hEr0bR1ne/surgeryBoxProject-next/docs/comparison-and-next.md

# 两版比较与 Next 迭代记录

比较日期：2026-09-09。本文以实际 Git 提交和源码为依据，未进行实物训练验证。

## 来源与结论

- 原工程：<https://github.com/hEr0bR1ne/surgeryBoxProject>，本地基线 `0187e78`（2.1.1）。
- 衍生工程：<https://github.com/ZiliShao222/surgeryBoxProject>，本次基线 `5d58073`。
- GitHub API 将衍生工程标为 `fork: false`，但其 Git 历史包含原工程的 `0187e78`。因此代码确实继承自原工程，只是没有 GitHub fork 元数据。
- 从原基线到衍生版主分支共有 14 个提交（包括合并提交）；差异为 89 个文件、12,591 行增加、558 行删除。归档硬件工程和文档也计入统计，不能把全部新增行数视为新功能。
- Next 以衍生版当前主分支为基础继续开发。保留作者和提交历史，原仓库不覆盖。

原工程已经具备软硬件训练闭环；衍生版将其拓展成包含教师端、体位与视觉感知、AI 分析和学习记忆的训练平台。下一阶段最值得投入的是模块边界、协议可靠性和可复现验证，而非继续向大型页面文件叠加功能。

## 功能与结构比较

| 维度 | 原工程 2.1.1 | 衍生版 5d58073 | 判断 |
| --- | --- | --- | --- |
| 硬件基础 | ESP8266 D1、双相编码器、舵机刹车、电机 | 继承硬件平台，增加诊断命令和 IMU 桥接 | 可继承，但硬件标定需重新核对 |
| 通信 | WiFi 热点、HTTP echo、UDP 训练事件 | 增加 USB 串口收发，UDP 保留 | 适合有线训练站；两种传输尚未完全统一 |
| 编码器 | A 相中断判向 | A/B 相边沿计数、正交状态转换、原始计数与引脚诊断 | 可观察性更好；沿用原每 tick 距离不等于已经重新标定 |
| 电机 | 回卷操作实现较简单 | 非阻塞回卷、15 秒上限、回零判断和方向切换 | 主循环响应能力改善；超时和反向策略需实测 |
| 体位 | 无独立 IMU 体位门控 | IMU 欧拉角，侧卧保持 3 秒，离开体位暂停和恢复 | 有价值的训练前置条件；阈值受安装姿态影响 |
| 界面 | 登录、训练、题库、记录、AI 对话 | 师生独立界面、注册、账户主题、中英文切换 | 明确区分教学管理与学员训练 |
| 摄像头 | 摄像头与手势识别基础能力 | 扩展相机控制、手部追踪和训练关联 | 保留成果，后续重点验证切换和释放资源 |
| AI | Nursing Mentor 对话 | 学员复盘、教师建议、LangGraph 流程、持久训练记忆 | 从问答转向训练数据分析；效果仍需样本评估 |
| 文档 | 无根 README | README 与 docs 专题文档、历史硬件测试目录 | 交接改善明显，但部分文档落后于代码 |

对应源码：`src/encoder.cpp`、`src/motor.cpp`、`src/imu_bridge.cpp`、`src/wifi_udp_server.cpp`、`simulator/app/hardware/serial_connector.py`、`simulator/app/imu_posture_reader.py`、`simulator/app/ui/teacher_shell.py`、`simulator/app/ai_training_graph.py`、`simulator/app/agent_memory.py`。

## 已确认的问题和待验证事项

1. **串口测试误报成功（本次修复）**：原 `SerialConnectionTestThread` 即使完全没有收到协议回复也发出 `True`；任意 ACK 或遥测也可能被视为成功。Next 要求本次探测收到精确 `ACK: HELLO_PC`，超时报告失败。
2. **配置与生成文件被提交（本次修复当前版本）**：本地与示例 AI 配置含硬编码密钥，且有 19 个被跟踪的 `.pyc`。Next 示例改为环境变量；本地配置、用户设置和缓存退出版本跟踪。旧提交仍存在，密钥持有人应撤销旧密钥；本迭代不重写上游历史。
3. **IMU 桥接未启用（接线复核更正）**：`main.cpp` 已注释 `imuBridgeInit()` 和主循环桥接调用，默认 ESP8266 控制走 COM6，桌面 IMU 读者走独立 COM3。`imu_bridge.cpp` 仍保留原始二进制透传实现，部分等待/回卷函数也残留调用；若将来重新启用桥接，会与同一 Serial 上的日志、文本协议混用。当前不能把该风险描述为默认运行状态。若合并为单串口，应实现统一读取与明确分帧。
4. **固件等待仍是阻塞循环（待解决）**：`waitForCmd`、`waitForCmdAny`、`waitShortPull` 在等待期间轮询部分服务，没有完整超时状态机。`Stop` 在普通处理分支未直接清除 `sequenceRunning`；不同等待分支对运行时命令的退出语义不同。应先建立命令状态表，再用台架验证暂停、终止、回卷与重新开始。
5. **编码器尺度需复核（待验证）**：计数方式变为 A/B 双相边沿后，`distancePerTick` 仍为 `0.0000507`。应拉出已知长度并比较 ticks，确认比例和方向；目前不能断言训练距离准确。
6. **主页面职责过多（待重构）**：`main_window.py` 约 183 KB，两个拔管训练实现分别约 135 KB 和 125 KB，AI 图约 77 KB。UI、训练状态、设备生命周期和数据分析交织，改一项容易影响另一项。
7. **运行环境与文档不一致（部分纠正）**：README 仍称缺少 openai，但当前 requirements 已包含；MediaPipe 模型与下载脚本在文档出现，当前树没有对应文件。图形界面、模型资源和真实设备仍需独立验收。
8. **存储依赖启动目录（待修复）**：`storage.app_root_dir()` 使用 `Path.cwd()`，从不同目录运行会得到不同的数据根；不能只修图片路径就认为整个应用支持任意目录启动。

## Next 0.1.0 的范围

- 继承衍生版所有功能和 Git 历史。
- 串口连接测试发送 `HELLO_PC` 前清空旧输入，使用单调时钟限制等待，只接受精确响应；异常交给线程现有错误处理。
- 示例 AI 配置从 `DASHSCOPE_API_KEY`、`DASHSCOPE_BASE_URL`、`DASHSCOPE_MODEL` 读取；默认模型与 DashScope 地址保持兼容。
- 停止跟踪本地配置、用户设置及 19 个 Python 字节码文件，忽略后续产生的训练数据。上游已经跟踪的历史训练数据未批量删除。
- 标记桌面版本 `Next 0.1.0`，增加无需 GUI、模型或硬件的协议测试与 CI。
- 本次不改变电机输出、体位判定阈值、训练事件距离或临床教学内容。

## 后续顺序

| 优先级 | 工作 | 验收条件 |
| --- | --- | --- |
| P0 | 单串口接入和明确消息分帧 | IMU 高频输入、设备日志与指令交错时不丢帧、不抢占端口 |
| P0 | 固件命令状态机 | 任意训练阶段 Stop、拔线、超时均进入明确定义状态，重新开始可重复 |
| P0 | 编码器与回卷台架验证 | 已知长度标定、反向、回零、堵转、超时及急停逐项有记录 |
| P1 | 提取训练状态与设备服务 | 虚拟训练、UDP、串口共享状态模型；纯逻辑可自动化测试 |
| P1 | 固定数据目录与账户数据迁移 | 从不同启动目录运行读取相同记录，迁移保留原记录 |
| P1 | 依赖与模型资产说明 | 新 Windows 机器按文档即可启动且缺模型时有明确提示 |
| P2 | AI 报告评估和记忆策略 | 固定样本复盘可解释，重复训练不会重复累计记忆，失败有明确回退 |

## 验证

自动检查与实物验证分开记录。执行 `python -m unittest discover -s tests -v` 和 `python tools/check_python_sources.py`。固件执行 `pio run -e d1`。没有连接实物时，不将编译通过视为电机、体位或完整训练验收通过。

### 本次实际结果（2026-09-09）

- Python 3.11.7：7 项回归测试全部通过，涵盖串口静默、无关 ACK、日志/二进制噪声、精确握手、断线异常，以及无本地配置时的 AI 默认配置与环境变量优先级。
- 43 个 Git 跟踪的 Python 源文件语法解析通过；未发现扫描规则覆盖的内嵌 provider key 形式。该检查不代表完整历史密钥审计。
- PlatformIO `d1` 固件编译成功（Espressif8266 4.2.1 / Arduino framework 3.1.2）；RAM 32,032 / 81,920 字节，Flash 319,543 / 1,044,464 字节。
- 未上传固件，未启动完整 GUI，未调用真实 AI 服务，未进行电机/IMU/相机实物验证。
