hEr0bR1ne/surgeryBoxProject-next/releases/surgerybox-v3-3.1.6/README.md

# 3.1.6 固件与验证记录

- `firmware.bin` 为 2026-11-13 烧录并校验的 WEMOS D1 R1 镜像。
- `upload.log` 摘录烧录校验结果，`operator-test.log` 摘录同一固件的带载回卷全过程关键报文。
- `validation.json` 记录镜像 SHA256、测试结果和回卷结果。

[交接说明](../../docs/AI-HANDOFF.md) · [实机验证](../../docs/v3-hardware-validation.md)
