hEr0bR1ne/surgeryBoxProject-next/releases/surgerybox-v3-3.1.0/README.md

# 3.1.0 / protocol=8：已烧录，用户现场测试通过

上电自动零点；无需手动标定两端；无拉出上限、无提前停车死区。舵机75°/秒，较3.0.1提高50%。
方向2计数增加，返回上电零点即关断，然后50ms停机、方向1释放1秒。显示归零与重连不改变上电零点。
跟踪失效后不能自动重设零点，须重启；保留编码器/失联/错向/堵转/120秒连续运行保护。

当前COM4已烧录3.1.0，290464字节Hash校验通过；boot=15e2c4-dd5d290c。25次只读检查通过，home有效、编码器errors0、输出关闭。烧录前隔离驱动VM/VCC及舵机正极，因为D8/GPIO0在复位期间可能误动。
软件到零关断不能保证机械惯性零超调，仍须现场观察停车结果。
构建、策略静态检查、13项GUI测试和13项SDK测试通过；本轮进行了只读串口验证，结束SAFE并释放COM4，没有发送启动执行器的指令。
主接口见docs/v3-hardware-api.md。旧protocol=7 SDK不能用于新版，旧ZIP不应再交接给上位机开发者。

后续用户测试证据见operator-test.log：多次舵机与灯开关、回卷token1715103486完成；首次舵机启用仍有一次error5，完成位置pos86/home0。以docs/AI-HANDOFF.md为当前交接入口。
