hEr0bR1ne/surgeryBoxProject-next/docs/archive/AI-HANDOFF-before-v3-release-20261109.md

# 历史工作记录（不作为当前指令）

# 当前交接：V3统一MCU接口（2026-11-09）

**最新用户要求覆盖下方旧端点/行程限制：当前COM4已烧录3.1.0 / protocol=8，290464字节Hash校验通过，boot=15e2c4-dd5d290c。25次只读检查通过，home有效、encoder errors0、deadzone_ticks0、extension_limit0、各路输出关闭。上电首个有效编码器样本自动记home=0；不需人工两端标定，无拉出上限、无最小行程、无提前停车死区，到零即关方向2再释放1秒。方向2的编码器符号已由日志验证为+1；舵机75°/秒，较3.0.1加快50%。保留编码器失效/失联/错向/堵转/120秒运行上限。显示ZERO与重连不改home，跟踪失效后本次home失效且不自动重设。最新接口见docs/v3-hardware-api.md。用户已重新确认执行器隔离并授权烧录；本轮未发送启动执行器的指令。退出发送SAFE并释放COM4。用户报告缓动后刹车不再断连，日志多次动作成功，但首次重新启用仍出现一次error5，不宣称根因已完全消除。以下3.0.0/3.0.1记录和历史标定要求不得覆盖本段与最新用户指令。**

**最新：用户确认执行器隔离并授权烧录后，COM4已写入3.0.1，296128字节Hash通过，boot=15e2c4-d57f700a。25次只读检查通过，编码器errors0、所有输出关闭、端点清空。未发送动作；1°/20ms缓动和1%停止余量待带电动作验证，错误5仍未确认修复。证据在releases/surgerybox-v3-3.0.1-candidate/。下方未烧录/板载3.0.0等描述均是先前阶段；旧交接ZIP未更新。**

**源码候选3.0.1，板载3.0.0：舵机1°/20ms非阻塞缓动，最后一步后500ms才启动回卷；停止余量10%→1%（最少32计数），近目标启动容差128→8。仅离线验证，未烧录/开串口/发送动作；旧交接ZIP仍3.0.0。错误5仍未解决，用户当前保留接线现场。**

**后续故障：用户舵机指令后需反复重连；日志确认Windows COM4读写error 5，重连boot不变。根因未定，不能直接认定电源或MCU复位。用户选择“暂不改线，先保留现场”，没有再发动作/烧录。先读v3-hardware-validation.md最上方，勿宣称实际动作后的通信稳定性通过，也不自动重连重放动作。**

新增全功能测试端tools/StartHardwareTest.cmd，配套tools/v3_test_client.py，说明docs/v3-test-console.md。
12项GUI检查及实机只读连接通过，电脑端不需要重烧MCU。当前已打开测试窗口并连接COM4（PID21840），串口由窗口占用；其他工具需先断开/关闭窗口。
独立测试端交付包releases/surgerybox-v3-test-console-20261109.zip已核验SHA256。连接只查询状态，未启动执行器。

用户要求硬件接口全部做好交给上位机开发者，已完成。当前板载firmware/v3（3.0.0 / API v1 / protocol=7），上位机入口host_sdk/surgerybox_v3.py。
先看[v3-hardware-api.md](v3-hardware-api.md)及[v3-hardware-validation.md](v3-hardware-validation.md)。不使用旧主程序、旧串口连接类或单项GUI。
可直接转交releases/surgerybox-v3-hardware-api-20261109.zip，包内23文件及SHA256已核验；镜像与当前COM4一致。
已通过构建/写入校验、12项SDK测试、四路隔离实机接口验收、100次状态查询及旧会话/重放/看门狗检查。
最终电机/灯低、舵机无脉冲、I2C有效，端点未登记；COM4已释放，用户确认电机及舵机正极仍隔离。
完整带负载回卷及1秒机械释放、停车惯性尚需上位机联合测试。下方为历史信息，不代表当前固件状态。

---

> **2026-11-09 最新100%版：用户明确要求最大驱动，确认VM仍主板5V、电机此前直连5V能转；收到当前执行器供电隔离确认后，COM4已烧录MOTOR_I2C_PROBE protocol=4、PWM1023/1023，286048字节写入Hash通过。长按与原行程/心跳/无进展/时限保护保留，18项GUI回归通过；串口确认CAPS pwm1023、缺端点HOLD拒绝、旧KEEP不启动，输出低、编码器errors=0，串口释放。先断电重登两端后用户手动测试，本轮未发有效驱动。实际驱动型号仍未核实，100%不是升压补偿。启动器tools/StartMotorProbe.cmd已更新；勿用旧25%/组合工具。详见[v3-bringup.md](v3-bringup.md)。**

> **2026-11-03 第三代接线变更：用户报告已更换MT6701，VDD接3.3V、M接GND；灯信号D3。现在仅USB供主板，驱动板、舵机、灯取主板5V，外部24V已不使用。插USB时电机短暂动作，原因及板载固件未确认；当前重新枚举到CH340 COM4。先读 [v3-bringup.md](v3-bringup.md)，不要把下面第二代供电、标定和烧录记录当作第三代已验证事实。**

> **2026-09-15 新板更换：原板据用户反馈损坏，已为新WEMOS D1 R1烧录同一电机禁用联调固件。COM4，ESP8266EX，MAC 80:7d:3a:11:d5:8b，写入校验通过。串口确认motor_enabled=0、active=0、home=0、D7/D8低，Winding被拒绝；BRAKE:ANGLE:0、LIGHT:OFF、ENC?查询正常。24V断开时核对，未验证外设实际动作；COM4已释放。**

> **最新实物状态：2026-09-11T01:08:29（本机北京时间），电机禁用的上位机联调主程序已烧录COM4，写入校验通过。实测19条电机命令全部返回ERROR: motor_disabled_handoff；motor_enabled=0、matrix=0、active=0、D7/D8均低。舵机指令0°、LIGHT:OFF及ENC?查询正常。24V断开期间核对，未测试外设实际动作。COM4已释放。**

> **2026-11-03 最新烧录：当前COM4为ServoTuner舵机独立调试固件，非主程序。全4MB原Flash已备份到hardware_backups/before_servo_tuner_20261103_v3/，新固件写入校验通过。握手TUNER:1、状态STATE:0,90,90，控制输出关闭，未发送角度指令。调试GUI已打开且未连接；COM4已释放。后续保持电机供电隔离，舵机首次启用默认从90°指令开始，需先核实机构允许。详见v3-bringup.md。**

> **2026-11-03 第三代刹车标定已整合源码：释放180°、弱阻尼120°、锁紧50°，微调50~180°，单次最多5°。本机主程序编译通过，尚未烧录；板上仍为上述ServoTuner。详见docs/brake-calibration.md及docs/v3-bringup.md。以下旧0°/55°/125°是第二代历史值。**

> **2026-11-03 编码器联调最新状态：当前COM4为ENCODER_I2C_14BIT。用户改接D4/GPIO4→M+Z，VDD=3.3V，D5=SDA、D6=SCL；固件D4输出HIGH。0x06读取与跨圈测试通过，运动采样1030帧均有效，约一圈约1.6万计数，I2C errors=0。停流回执重试恢复，复核通过、COM4已释放。未写EEPROM。主程序仍用A/B且尚不兼容新接线，新距离/原点/行程未标定；执行器保持隔离。详见v3-bringup.md。**

> **2026-11-05 最新需求：用户仅要相对位置，不要求毫米换算或尺量标定，200mm试验未完成且未生成系数。已在隔离执行器条件下打开“SurgeryBox · 编码器相对位置”GUI（PID 3448），COM4被实时读取占用。诊断ZERO后相对计数0，14位读取正常、errors=0；一圈16384计数，窗口显示相对角度/圈数。未烧录新固件、未设机械原点。先看v3-bringup.md最新开头。**

> **2026-11-05 电机最新：当前COM4为MOTOR_I2C_PROBE，端点0~18949、控制1894~17055；中段8034。用户恢复原5V驱动供电后，执行一次IN1 PWM/IN2 LOW官方接法短脉冲，无位移、no_progress停止，随后MS核验输出低、未解锁、串口释放。尚未确认实际驱动芯片；A4950官方VM要求8~40V。用户要求只按官方指引，不做旧组合试验；暂停进一步点动，先核实型号/供电。刷机前隔离电机电源，RAM参考复位失效。详见v3-bringup.md最新开头。**

> **2026-11-09 用户最新反馈：100%版本测试成功，方向2回卷；方向1使机构允许拉出，否则摩擦轮锁住。待确认方向1需短按还是持续按，不自动加入释放脉冲；仍protocol=4，未改固件或发送动作。见v3-bringup.md最新段。**

> **补充确认：方向1只需短按即可保持可拉出，无需持续驱动。后续正常回卷完成应停机→方向1短暂释放→停止；释放毫秒值未标定，尚未实现或烧录。故障/急停不自动触发反向释放。见v3-bringup.md。**

> **2026-11-09 当前protocol=5：用户指定方向1运行1秒，已隔离确认后烧录COM4（287792字节Hash通过）。正常回卷松手/收回端正常完成：停50ms→方向1/100%1000ms→停止；故障急停不反向。释放允许无位移，保留心跳/编码器/位移与物理范围限制。23项GUI回归与编译检查通过，实机CAPS确认1000ms、缺行程拒绝释放，输出低、编码器errors=0；串口释放，未执行有效驱动。用户须重登两端后验证机械释放。前述protocol=4已被替代，详见v3-bringup.md。**

> **2026-11-09 当前protocol=6：已隔离确认后烧录288000字节，新增LIGHT:ON/OFF/?；D3/GPIO5回读LOW→HIGH，用户却观察灯未亮。当前D3留HIGH供测量，COM4释放，电机/舵机仍隔离、无有效驱动；等待模块VCC-GND及IN-GND电压。GUI连接会关灯，暂不启动连接；灯尚未通过，整机接口阶段未开始。详见v3-bringup.md。**

> **2026-11-09 灯最终结果：线路修正后，用户确认D3高电平实体灯“亮了”；已发LIGHT:OFF并查询确认D3=0，COM4释放，当前protocol=6。此前未亮/待测量/留HIGH为历史。可进入MCU/上位机接口整合，但主程序仍电机禁用且未整合新I2C，1秒自动释放完整机械效果及停车惯性仍需联调验证。详见v3-bringup.md。**

# SurgeryBox 硬件与上位机交接（AI 首读）

更新日期：2026-09-09。本文件是本次交接的状态摘要。较早文档中的引脚、角度、测试计划和“尚未烧录”记录可能已经过时，以本文件的状态和对应源码为准；不能把已写代码等同于实机验证通过。

## 给接手者 / AI 的任务

用户已完成下面列出的硬件单项测试，上位机联调由接手者负责。请先阅读本文件、根目录 `AGENTS.md` 和对应代码，不要求用户重新口述所有历史。先在无电机输出条件下检查上位机流程；电机异常单独处理。涉及实物状态、接线变更、上电或刷写，必须先核实现场现状，不能默认仍是本文记录的状态。

可直接把这段作为 AI 初始任务：

> 请先阅读 AGENTS.md 和 docs/AI-HANDOFF.md，区分“已实测”“仅实现”“未解决”。接手上位机与 ESP8266 联调，保留舵机标定和物理行程限制。不要启动电机、假定电机方向已确认或假定当前板上是主程序；先核实运行固件。在不涉及电机动作的范围内完成代码检查和测试，列出完整训练流程还缺哪些实机验证，再继续推进。

## 当前上位机联调版（2026-09-11）

用户决定暂停电机故障排查，交由另一位协作者开展上位机联调。当前源码在 `include/config.h` 固定 `MOTOR_OUTPUT_ENABLED=false`；本次烧录结果另见 `main-firmware-restoration.md`，不能用代码完成代替烧录确认。

- 电机D7/D8启动为低。`Winding`、MF/MR、MotorForward/MotorReverse以及所有 `MOTOR:` 设置、PROBE、JOG、MATRIX命令均拒绝，返回 `ERROR: motor_disabled_handoff`。内部启动函数也拒绝输出，不能通过串口解锁。
- `TRAVEL?` 返回 `motor_enabled=0`、`matrix=0`、`active=0`。MS和Stop仍可用；Stop依然锁紧舵机125°，不是仅停电机。
- 舵机0°/55°/125°标定、编码器读数和训练事件、实体血迹灯、USB串口/UDP接口保留。电机物理零点不是开展灯/舵机/编码器联调的前提；不要为了联调在任意位置登记机械原点。
- 上位机应显示“电机暂不可用”，不能把Winding拒绝当作完成回卷，也不能无限等待成功回执。现有 `training_remove_needle_mcu.py` 有发送Winding的入口，接手者需据此处理提示/跳过电机步骤；未伪造完成回执。
- 电机故障仍未解决。用户最终组合反馈：AIN2低（0/3/6）不转，AIN2为PWM（1/4/7）同向转，AIN2高（2/5/8）高速同向转；这是用户观察，不是示波器实测。此前输入反插曾观察到离合器脱离，之后恢复D7→AIN1、D8→AIN2进行组合测试。不能认定正常反向回卷已验证。
- 当前GUI电机测试工具遇到禁用固件会明确提示不可用。独立常转固件和旧组合固件仅保留为历史排查资料，不用于本次上位机联调。

## 硬件接线与电源

板型：**WEMOS D1 R1 / PlatformIO `board = d1`，不是 D1 mini。** 本机串口曾为COM4，其他电脑须自行枚举。

| 功能 | 板上引脚 | ESP8266 GPIO | 说明 |
| --- | --- | --- | --- |
| 舵机刹车信号 | D2 | 16 | 用户已验证可转，完成角度标定 |
| 血迹灯 MOS 控制 | D3 | 5 | 高电平亮，低电平灭 |
| 编码器 A 相 | D5 | 14 | 双边沿计数 |
| 编码器 B 相 | D6 | 12 | 双边沿计数 |
| 电机 AIN1 | D7 | 13 | 当前配置，电机故障未解决 |
| 电机 AIN2 | D8 | 0 | GPIO0 是启动配置脚；复位/下载期不受程序限位保护 |
| USB 串口 | D0 / D1 | 3 / 1 | RX / TX，不能误认成其他板型的D1/D2映射 |

电源事实：主板连接电脑USB。**编码器、电机、舵机、灯全部最终来自外部24V，经各自所需的降压/驱动电路供电。** 不是所有元件的输入端都直接接24V。切断整套24V也会切断编码器供电，期间移动不会被记录。

用户万用表确认：驱动板VCC由降压输出供电，实测4.98V；VM为24V；主板与驱动板GND导通；D7↔AIN1、D8↔AIN2导通；电机与控制输入属于同一A通道。

## 标定值与验证范围

| 项目 | 结果 | 验证程度 |
| --- | --- | --- |
| 舵机释放 / 弱阻尼 / 锁紧 | **0° / 55° / 125°** | 用户用舵机调试工具实测并导出，已整合 `src/servo_brake.cpp` |
| 血迹灯 | GPIO5高电平亮；LIGHT:ON/OFF | 用户确认看见实体灯亮灭；上位机完整训练联动尚待验证 |
| 编码器 | 手动正反转计数增减，两相信号均有反馈，停住计数稳定 | 已实测 |
| 最大手动行程 | **34891 ticks** | 在用户指定原机械零点清零后拉到底、停留再回转；串口采样峰值 |
| 控制上下限 | **1745～33146 ticks** | 两端各内缩约5%；软件配置，不是实测动力停止范围 |
| 暂定回卷提前断驱动点 | **1945 ticks** | 比下限提前200ticks；停机惯性尚未验证 |
| 距离系数 | **0.0000507 m/tick** | 历史值，本次未用尺重新标定；不要把显示米数当实测 |
| 电机方向、收线、停车惯性 | 未确认 | 见下文故障；完整回卷未通过 |

机器可读记录：`hardware_tests/servo_calibration.json`、`hardware_tests/encoder_range_calibration.json`。舵机角度是指令值，不是角度传感器或刹车力测量。

## 电机未解决问题：已确认观察，不是诊断结论

模块商品名称为“A4950双路电机驱动模块 直流有刷电机驱动板模块 超TB6612”。淘宝短链接无法从检索工具读取完整原理图，**实物模块是否与标准A4950外围电路完全一致尚未核实**。

1. 曾以PWM300/1023约29%输出，在中段分别测试R/F方向，先150ms、再500ms；编码器没有位移。用户曾观察到声音/轻微抖动或轴转，但不卷线。
2. 改为最多2秒、PWM512约50%，F方向测试前位置14680，结束仍14680。用户后来使用GUI自行调至PWM663等，反馈电机仍无明显动作。GUI日志确认命令被接收、进入probing，约2秒后MS停止，不是按钮没有发命令。
3. 用独立常转固件排除PWM、串口定时、编码器限位。串口确认GPIO13=1、GPIO0=0；用户在驱动板端测得AIN1约3.3V、AIN2约0V，但电机仍不转，电机两端报告0V。
4. **D7/D8两根控制线接上时不转，拔掉后电机反而转。** 拔线后的两路输入电平、输出电压、持续转动方向尚未记录。不能据此就认定是反相控制或普通悬空。
5. **用户意外短接ESP8266主板5V与GND时，电机转；解除短接后立即不转。** 短接的是主板，不是驱动板。未确认短接时主控是否复位、引脚状态和各路电压。不得重复短接作为诊断手段。
6. 用户已确认供电、共地、同通道与连线导通。不要把这些当作从未检查过；如需重测应说明新的目的。没有证据可以直接认定某个器件损坏，也不能因软件读回高低就认定真实驱动波形完全正确。

官方参考：[Allegro A4950 datasheet](https://www.allegromicro.com/-/media/files/datasheets/a4950-datasheet.pdf)，第3页：高电平门限2V，低电平上限0.8V，内部约50kΩ下拉；第4页：10/01方向相反，00高阻滑行/待机，11制动。一路PWM、另一路低属于标准控制方式。两输入断开后主动持续转动不是标准默认行为。模块厂商[同类双路板说明](https://easyelecmodule.com/product/a4950-dual-motor-drive-module/)区分VCC5V和VM，但不能把同类说明当成该淘宝实物的原理图。

罗老师将协助判断。后续应根据实物电路/真实输入输出状态定位，不要只提高PWM、延长时间或无依据更换接线。常转程序只用于与卷线负载机械脱离后的空载台架验证。

## 主程序目前实现的协议与限制

固件115200波特率，换行结束命令；根目录主程序也支持UDP4210和HTTP echo。WiFi/串口具体入口见 `src/wifi_udp_server.cpp`。

| 命令 | 行为 / 注意事项 |
| --- | --- |
| HELLO_PC | 回复ACK: HELLO_PC；连接成功须核实身份 |
| ENC? | 相对计数、旧系数距离、A/B电平与边沿次数、训练状态 |
| ZERO / Start | 重置训练相对计数，不重置新增物理限位计数；电机运行时拒绝 |
| TRAVEL? | home、pos物理计数、low/high/stop、direction、active、pwm、reason |
| TRAVEL:HOME | 用户在原机械零点确认后登记物理零点；必须电机/训练空闲，禁止自动发送 |
| MOTOR:PWM / PROBE / JOG / MATRIX | 当前联调版全部拒绝：ERROR: motor_disabled_handoff |

| Winding | 当前联调版拒绝，不返回回卷成功；上位机需显示暂不可用 |
| MF / MR | 旧直驱命令已禁止，不能绕过保护 |
| MS | 保持两路低电平并回复ACK: MotorStop；不等于断开24V |
| Stop | 停电机并锁紧刹车125°；不同于仅停止电机的MS |
| BR / BW / BL | 舵机释放0° / 弱阻尼55° / 锁紧125° |
| BRAKE? / BRAKE:ANGLE:n | 查询指令角度 / 空闲时0～125°、单次最多5°微调 |
| LIGHT:ON / OFF / LIGHT? | 实体灯控制和指令状态回读，不是光传感器测量 |

`encoder.cpp` 中物理计数与相对计数分开，`motor.cpp` 上电物理参考无效；不能用断电后的旧计数恢复绝对位置。电机保护在主循环和原等待循环调用；完整回卷的无净反馈上限500ms、总时长15s，方向反向超过8ticks停机。试转无反馈等待单独为2s。保护是软件逻辑，尚不能保证实际机械停车不超界。

## 上位机交接重点

- `simulator/app/hardware/serial_connector.py`：串口握手与收发；USB串口默认COM4，可用 `SURGERYBOX_SERIAL_PORT` 覆盖，避免默认DTR/RTS引起复位，但仍需读回实际固件/零点。
- `simulator/app/hardware/blood_light.py`：实体灯指令确认、重试和退出关闭。
- `simulator/app/ui/blood_light_training.py`：训练界面灯控制接入。
- `training_remove_needle.py` 与 `training_remove_needle_mcu.py`：阶段3.5用实体灯替代虚拟血迹，默认 `SURGERYBOX_BLOOD_LIGHT=1`；设0回退虚拟显示。
- 带相机流程仍保留原约8秒自动擦拭完成逻辑，灯灭不一定代表视觉识别擦拭成功；纯MCU模式 `disable_camera` 会跳过阶段1～3.5，所以不能假定该模式一定点灯。
- 目前代码存在并有自动测试，不代表已经验证过真实相机/IMU/完整训练；当前主固件的IMU桥初始化与循环处于禁用状态。
- 接手者应补测：真实串口握手、灯确认与阶段切换、传感器距离事件、刹车预设、中途退出/停止/断连、完整训练与数据记录。先隔离电机动作，不能直接拿常转固件联调。

## 工具、备份与复现

| 路径 | 用途 |
| --- | --- |
| hardware_tests/servo_tuner | 舵机GUI与配套独立固件 |
| hardware_tests/motor_tuner | 电机GUI，使用主程序；F/R、PWM、时间、位置、停止原因、JSON导出；不自动连接或启动 |
| hardware_tests/encoder_only | 编码器独立固件，复用主解码代码，无执行器初始化 |
| hardware_tests/motor_continuous | 用户手动烧录的常转程序；无软件停止功能 |
| hardware_tests/servo_manual、servo_only | 早期单舵机测试，不是主程序 |
| tools/encoder_logs | 手动量程与短脉冲测试原始记录；部分早期脚本会操作硬件，运行前读源码 |

主固件源码始终保留在 `src/`、`include/`。常转测试之前已做本地备份：`hardware_backups/before_motor_continuous_20260909_221550/`，含源码ZIP、firmware.bin/elf及哈希清单。**该目录被Git忽略，不在GitHub中**；需要原二进制可向用户索取，或从本仓库编译主固件。备份是本地构建产物，不是设备Flash全量读取。旧firmware.bin SHA256：`2ba47082ab17aeb61ff525247a4f475564dd4bf14d9e6841d2bec1f90e180a61`。RAM中的零点、PWM和方向确认不随备份恢复。

无硬件验证命令（仓库根目录）：

```powershell
python -m unittest discover -s tests -v
python -m unittest discover -s hardware_tests/motor_tuner -p test_motor_tuner.py -v
python -m unittest discover -s hardware_tests/servo_tuner -p test_tuner.py -v
python tools/check_python_sources.py
python -m platformio run
```

GUI测试需要PySide6，可使用 `QT_QPA_PLATFORM=offscreen`。板型工具链需PlatformIO；本次实际版本为espressif8266 4.2.1 / Arduino core 3.1.2。`tests/travel_limits_compile_test.cpp` 可用ESP8266工具链的g++以 `-std=c++11 -fsyntax-only -I include` 检查。不要把upload或硬件测试脚本当普通CI测试自动运行。

本次尚未完成：真实完整上位机训练联调、准确长度换算、电机驱动异常定位、收线方向确认、惯性停止余量、动力回卷全程验证。

交接发布前检查：主项目17项、电机GUI9项、舵机GUI7项测试全部通过；61个已跟踪Python文件语法与凭据模式检查通过；限位C++编译期检查通过。测试未连接或驱动现场硬件，不能替代上面的待完成实机验证。
