hEr0bR1ne/surgeryBoxProject-next/docs/encoder-travel-calibration.md

> 最新交接状态请先读 [AI-HANDOFF.md](AI-HANDOFF.md)。本文包含历史说明或逐次测试记录，部分状态已被后续记录更新。

# 编码器全行程记录

用户要求：以本次指定位置为 0，手动拉到底并回转，保存最大量程；今后所有卷线动作不得超过此行程。

2026-09-09，COM4 / WEMOS D1 R1 主固件，A=D5/GPIO14、B=D6/GPIO12。收到 ZERO 的确认后连续查询 ENC?，全程未发送电机动作命令。

本次峰值为 **34891 ticks**，拉出为正方向。该值以用户指定的机械零点为基准，不能将任意位置重新清零后继续套用。

完整采样结果保存在 `hardware_tests/encoder_range_calibration.json`，原始日志位于 `tools/encoder_logs/`。这是串口采样观测到的峰值，不是硬件锁存的极值；在端点停留后回转。本次未用尺测量，不将旧的 0.0000507 m/tick 换算值作为已验证长度。

## 后续卷线的强制约束

- 物理行程区间为 0–34891 ticks；回卷不得越过零点，放线不得越过上端点。
- 应在端点之前停机，留出根据速度和停机惯性实测的余量；本次尚未标定余量。
- 必须在固件层覆盖自动 Winding、手动 MF/MR 以及等待训练确认的执行路径，不能只靠上位机限制。
- 启动时物理位置未知则禁止电机，须在原机械零点确认归零。训练 Start 的相对清零不能移动物理限位基准。
- 编码器无反馈、计数方向异常、超时均须停机；到端点不能使用试转并自动反向的旧逻辑。

## 当前实施状态

已完成手动测量和约束记录，**未烧录新的行程保护代码，也未做动力卷线测试**。当前主固件仍有 Start 自动重置编码器、手动电机无行程限制、回卷方向异常后试切换方向的旧逻辑。后续卷线开发必须先实现并验证上述保护，不能把本文件的记录当作保护已经生效。

## 2026-09-09 回卷保护实现（待实机验证）

用户接受两端各内缩 5%：控制区间 1745–33146 ticks。新增 include/travel_limits.h；初次回卷在 1945 ticks 提前关闭驱动，另留 200 ticks 暂定惯性余量，尚不能视为实测保证。

主程序 motor.cpp 已替换旧的自动反向试错逻辑：
- 上电物理零点无效，拒绝电机输出。人工回到原机械零点，明确发送 TRAVEL:HOME 后才建立坐标。
- 独立的物理计数不受训练 Start / ZERO 相对计数清零影响。
- TRAVEL? 返回物理位置、上下限、提前停止点、方向和运行状态。
- 在 14000–20000 ticks 中段，MOTOR:PROBE:R 或 MOTOR:PROBE:F 只运行 150 ms 或 150 ticks。PWM 300/1023，双相信号与位移满足条件后才确认回卷方向。
- Winding 使用确认后的方向，禁止在范围外启动；在下端提前停止，越过上限停机，方向反向超过 8 ticks 停机，500 ms 无双相净回卷进展停机，总时长上限 15 s。不再自动切换方向重试。
- MF/MR 直驱已禁用，运行期间拒绝 Start / ZERO，所有原有等待循环仍调用 motorUpdateWindBack。

编译期测试 tests/travel_limits_compile_test.cpp 覆盖边界、方向异常、反馈丢失、超时与短脉冲时长/位移限制。上电拒绝驱动、物理零点建立、真实电机方向、惯性余量和回卷停点仍须现场验证。D8/GPIO0 在烧录复位时不受固件保护，烧录前断开电机外部供电。

### 2026-09-09 烧录后检查

保护主固件已烧录 COM4，写入哈希验证通过。TRAVEL? 返回 home=0、low=1745、high=33146、stop=1945、direction=unknown、active=0；BRAKE?=0；D7/D8 均低。外部电机供电断开时，已验证未归零的 Winding 被拒绝，仍 active=0 且 D7/D8 低。尚待用户恢复原机械零点，再确认坐标、中段短试转及回卷停点；不能将上电 pos=0 当作机械零点已确认。

### 中段方向脉冲：未确认方向

2026-09-09 用户确认所有外设（编码器、电机、舵机、灯）均由外部24V经相应电路供电，只有主板由USB供电。断开24V也会中断编码器测量，期间不得把未记录的移动当作位置已知。

恢复整套24V后确认 home=1、pos=0、BRAKE=0、D7/D8低。用户手动拉到中段并稳定在18386。执行一次 MOTOR:PROBE:R（PWM300/1023，150ms或150ticks限制），固件从 active=1 回到 active=0，报告 probe_insufficient_feedback，计数始终18386。随后MS并核对D7/D8低；未执行完整Winding，方向仍unknown。

原始记录：tools/encoder_logs/probe_20260909_211802.json。下一步依据用户对声音/抖动/转轴的观察诊断，不能因未确认方向直接从上限启动回卷。

### 可调 PWM 更新（编译通过，待烧录）

用户观察首次300/1023短脉冲有声音或轻微抖动，但不卷线；原因尚未确定。新增 MOTOR:PWM:<300-700>，仅空闲时接受三位整数。修改输出不会启动电机，并清除方向确认，须重新短试转。默认仍300；下一次计划显式设为512（约50%），保持150ms/150ticks限制。TRAVEL? 新增pwm字段。新主程序已编译通过，尚未烧录。

### 用户最新调整：先延长时间，不提高PWM

用户希望先让电机运行更久。下一次测试改为默认PWM300/1023（约29%），时间上限500ms；仍在移动150ticks时提前停止，500ms无反馈也会停止。先前计划的PWM512测试暂缓，可调PWM接口保留但不自动提高输出。更新后的限位编译期测试与主程序编译通过，尚未烧录。板上仍是150ms固定PWM300版本。

### 500ms版本已烧录并重新归零

用户确认已回原零点且整套24V断开后，500ms试转版本烧录COM4成功、哈希校验通过。读回pwm=300、active=0；按用户确认执行TRAVEL:HOME，读回home=1、pos=0，BRAKE:ANGLE:0，D7/D8低。尚待恢复整套24V后在中段进行500ms实机试转；未发送试转或完整回卷命令。

### 500ms / PWM300 实机结果

恢复整套24V后物理读数-3，用户手动拉至中段并稳定17580。执行一次MOTOR:PROBE:R，持续约500ms，位置全程17580，固件返回no_encoder_progress并自动停机；随后MS核对active=0、D7/D8低。方向仍unknown，未启动完整回卷。原始日志tools/encoder_logs/probe_20260909_212421.json。单纯从150ms延长至500ms尚未带来编码器位移；等待用户观察电机轴是否转动，以区分启动不足与传动问题。

### 相反F方向短试转

用户提出可能方向反了，并确认24V保持接通。中段17580静止、PWM300预检通过后，发送一次MOTOR:PROBE:F，最多500ms。计数仍17580，固件报告no_encoder_progress并停机，MS后D7/D8低，direction仍unknown。日志tools/encoder_logs/probe_20260909_212608.json。R/F均未产生编码器位移，不能仅据此认定传动损坏或确定收线方向；需用户观察本次轴/卷线轮方向与线松紧变化。脚本现在必须显式选择--direction F或R，并检查PWM300。

### 最新计划：2秒、50% PWM（待烧录）

用户要求将时间增至2秒并加大输出。PROBE_MS现为2000；仅试转的无反馈等待同步为2000ms，正常回卷仍500ms无净进展停止。150ticks试转位移限制及上下限保留，故有位移时可能早于2秒停机。边界、超时编译期测试与主固件编译通过。

下一次烧录后，空闲时显式发送MOTOR:PWM:512，再以--expected-pwm 512运行一次方向试转。当前板上仍是500ms版本且PWM300，尚未执行2秒/50%测试。脚本延长到5秒观察停止后位置。

### 2秒版本已烧录，PWM512已设定

用户确认已回原零点且整套24V断开后，2秒受限试转主程序烧录COM4并通过写入哈希校验。执行TRAVEL:HOME读回home=1、pos=0；MOTOR:PWM:512读回pwm=512、active=0、direction=unknown。BRAKE=0，D7/D8低。未发送动力试转命令，下一步恢复整套24V并手动定位中段，再以--expected-pwm 512进行一次受限方向测试。USB重启会使物理参考失效、PWM恢复300，必须重新读取确认。

### F方向2秒/PWM512试转结果

整套24V恢复后home=1、pos=1、pwm=512、active=0。用户定位中段，试转脚本发命令前连续三次读到14680且静止，通过14000–20000中段预检。发送一次MOTOR:PROBE:F（2s上限、PWM512），读数未变化，最终reason=no_encoder_progress、active=0，MS后D7/D8低。方向仍unknown。原始日志tools/encoder_logs/probe_20260909_213144.json。等待用户观察线是松开、收紧或只有轴转；不把编码器无位移等同于电机不转。

### 电机手动测试工具

新增 hardware_tests/motor_tuner/StartMotorTuner.cmd 与 motor_tuner.py，兼容板上2秒保护版主程序，无需新固件。提供F/R、PWM300–700、请求运行时间100–2000ms、停止、物理位置与保护状态、原机械零点确认、现场观察和JSON导出。连接不自动归零或运行；PWM确认后才发送单次PROBE，未归零/非中段/状态陈旧禁止启动。停止与关闭发送MS，固件仍提供2秒与150ticks上限。7项无硬件GUI逻辑测试通过，窗口截图检查通过。当前工具已启动但未自动连接串口，也未执行电机动作；由用户自行测试并导出记录。
