hEr0bR1ne/surgeryBoxProject-next/hardware_tests/motor_tuner/preview.png

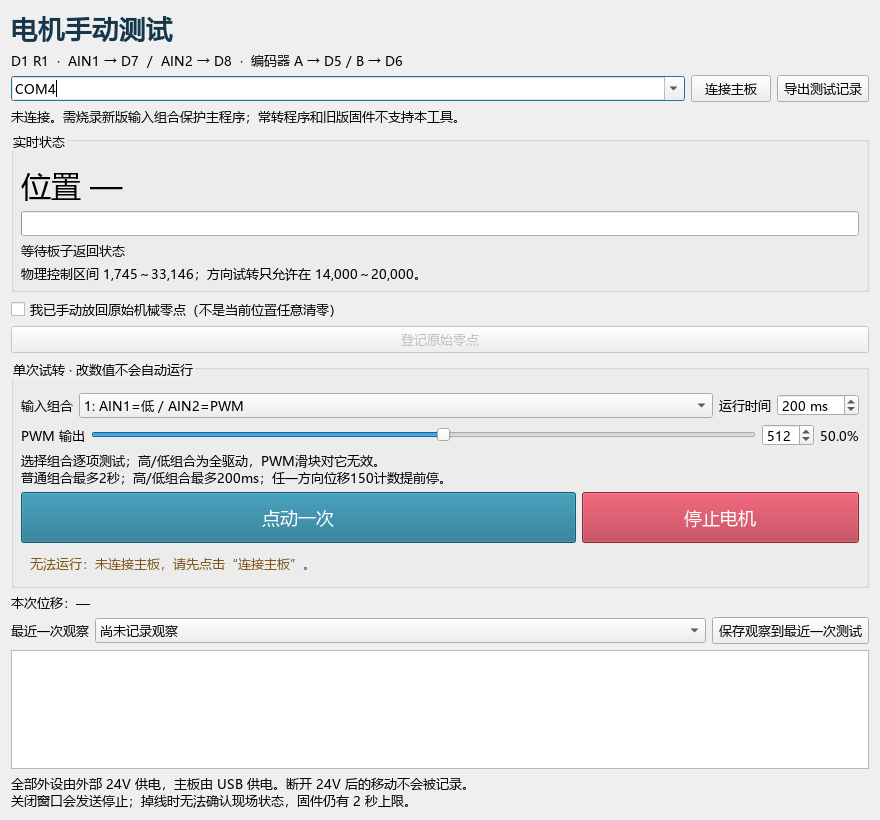
hardware_tests/motor_tuner/preview.png
