hEr0bR1ne/surgeryBoxProject-next/hardware_tests/servo_tuner/preview.png

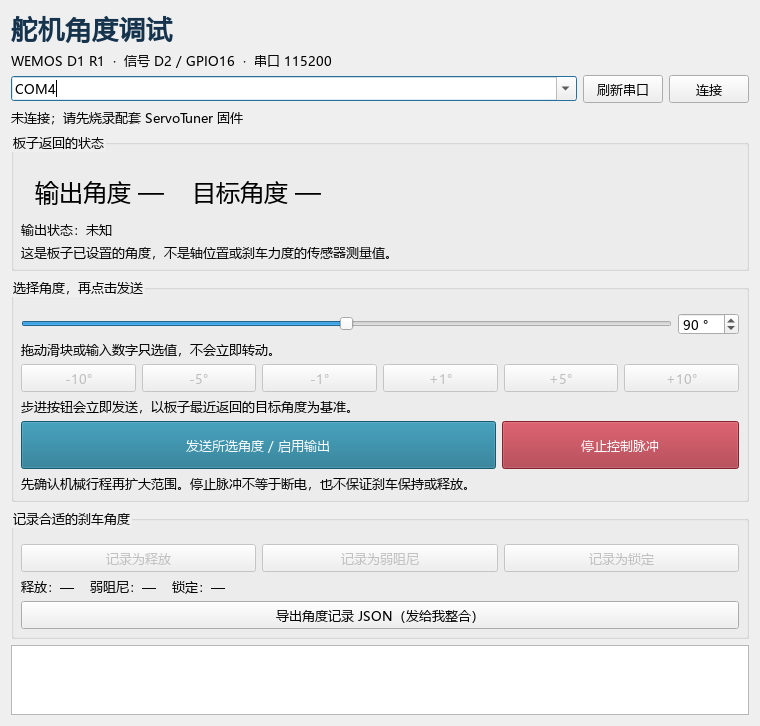
hardware_tests/servo_tuner/preview.png
