hEr0bR1ne/surgeryBoxProject-next/(commit log)

2026-09-09 Document hardware handoff with calibration, diagnostics and current firmware
    [servo_calibration.json]
2026-09-10 Record continuous motor test firmware flashed again
2026-09-10 Fix direction PWM motor jogs and document clutch behavior
    [MotorContinuous.ino, motor.cpp, motor_tuner.py, test_motor_tuner.py, travel_limits.h, travel_limits_compile_test.cpp]
2026-09-10 Add guarded nine-combination motor input tester
2026-09-10 Disable motor output for upper-computer integration handoff
2026-09-15 Record disabled motor firmware flashed to replacement board
2026-11-09 Release V3 hardware API 3.1.0 with automatic power-on zero
